nhatnamhuynh/obstacle-detection-and-distance-measurement/README.md

## 1. Project Overview
This project implements STM32 into an obstacle warning system for vehicles. It triggers the ultrasonic waves, detects obstacles and calculates how far the objects are using the reflected ECHO signal. Based on real-time distance, it warns the user through multiple channels, including LEDs, Buzzer, and LCD display. The system also transmits data logs periodically to the server using the U-ART interface, reporting realistic operation data for testing and future developments.

## 2. Learning Objectives
* Practice embedded C programming on STM32 with HAL library.
* Understanding and applying Timers, Input Capture, Interrupts, I2C, U-ART, PWM, GPIO into a practical project.
* Design a finite state machine for distance-based warning states.
* Implement a non-blocking main loop using time-driven events.
* Apply logical framework into utilizing the overall system and deliver cutting-edge test cases. 
* Enhance documentation and project presentation.

## 3. Hardware

### 3.1. Overview
Below is the detailed Bill of Materials (BOM) used to build the system:

| Component Category | Part / Module Name | Description / Specifications |
| :--- | :--- | :--- |
| **Microcontroller Board** | STM32F103C8T6 (Blue Pill) | ARM Cortex-M3 core @ 72 MHz |
| **Programmer / Debugger** | ST-Link V2 | SWD programming & debugging interface |
| **Primary Sensor** | HC-SR04 Ultrasonic Module | 2 cm – 400 cm range, 40 kHz acoustic frequency |
| **Display Interface** | 16x2 Character LCD + PCF8574 | I2C communication interface module |
| **Acoustic Actuator** | Passive Piezoelectric Buzzer | Driven via Timer PWM |
| **Visual Indicators** | 3x LEDs (Green, Yellow, Red) | Driven via GPIO with 220Ω current-limiting resistors |
| **User Input** | 1x Tactile Push-Button | Unit conversion (cm / inch), 10kΩ pull-up resistor |
| **Serial Telemetry** | CP2102 USB-to-UART Module | Transmitting logs to Serial Terminal on PC |
| **Software Toolchain** | VS Code, STM32CubeMX, Arm GNU Toolchain, CMake, Ninja, STM32 Programmer CLI| Software tools for programming and compilation |

*Note:* The system uses an independent step-down power supply module to provide 5V (for the sensor and LCD) and a stable 3.3V for the STM32 microcontroller during operation, preventing voltage drops when peripherals are activated.

### 3.2. Pinout Schematic
The peripherals are connected to the STM32 microcontroller through the pin configuration on STM32CubeMX as follows:

| Peripheral | Microcontroller Pin | Function |
| :--- | :--- | :--- |
| **HC-SR04 (Trig)** | `PA1` | GPIO Output |
| **HC-SR04 (Echo)** | `PA0` | Timer Input Capture |
| **Push-Button** | `PA2` | EXTI External Interrupt (Unit conversion) |
| **Green LED (Safe)** | `PB3` | GPIO Output |
| **Yellow LED (Warning)** | `PB4` | GPIO Output |
| **Red LED (Danger)** | `PB5` | GPIO Output |
| **Buzzer** | `PB8` | Timer PWM (Beep frequency control) |
| **LCD 16x2 (SCL)** | `PB6` | I2C SCL |
| **LCD 16x2 (SDA)** | `PB7` | I2C SDA |
| **UART (TX)** | `PA9` | UART TX - Transmit log data to Terminal |
| **UART (RX)** | `PA10` | UART RX - Receive data |

### 3.3. PCB Layout
* **Design Tool:** The project's PCB is professionally designed using **Altium Designer** software.
* **Component Layout:** The board is logically divided into sections including: Headers for the Blue Pill microcontroller, UART module pins, HC-SR04 sensor, LCD screen, push-button area, buzzer, and a cluster of 3 terminal blocks for outputting signals to the warning LEDs.

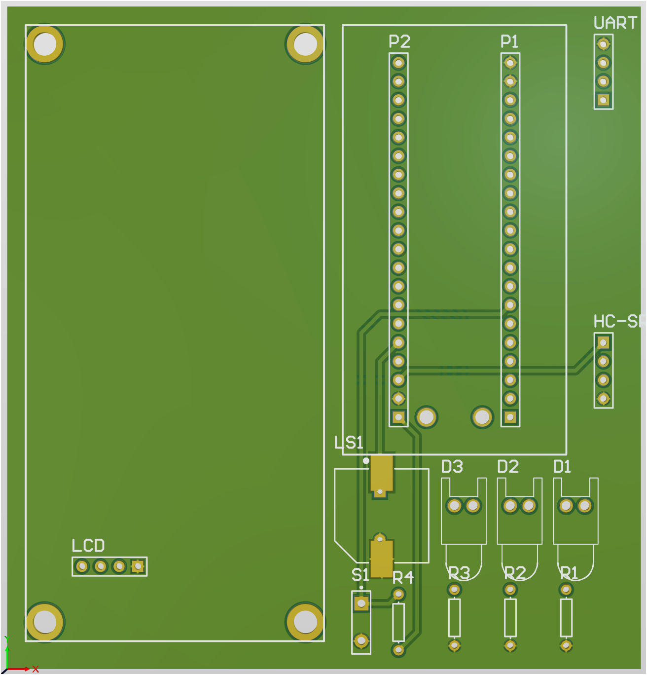
[picture p1: Picture/[MLIoT Project] Front PCB.png]
Front PCB Layout

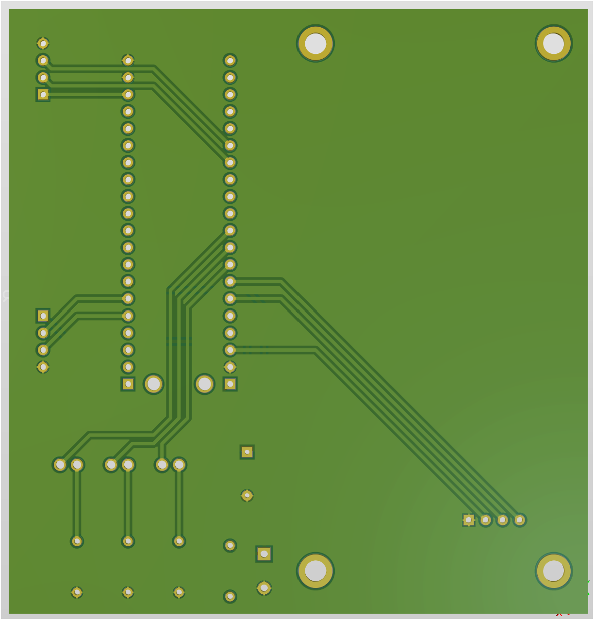
[picture p2: Picture/[MLIoT Project] Back PCB.png]
Back PCB Layout


---

## 4. Software Implementation

### 4.1. Overview: Development Tools and Libraries
The software architecture employs a non-blocking, interrupt-driven design, substituting hardware interrupts for blocking software delays to minimize CPU idle time. The development environment and toolchain consist of:
*   **IDE & Code Editor:** Visual Studio Code.
*   **Configuration & Initialization:** STM32CubeMX.
*   **Compiler & Build System:** Arm GNU Toolchain, CMake, and Ninja.
*   **Flashing & Debugging Tool:** STM32CubeProgrammer CLI (Automated via custom `build_and_flash` shell/batch scripts).
*   **Core Libraries:** Hardware Abstraction Layer (HAL) and Standard C Libraries.

### 4.2. System Block Diagram

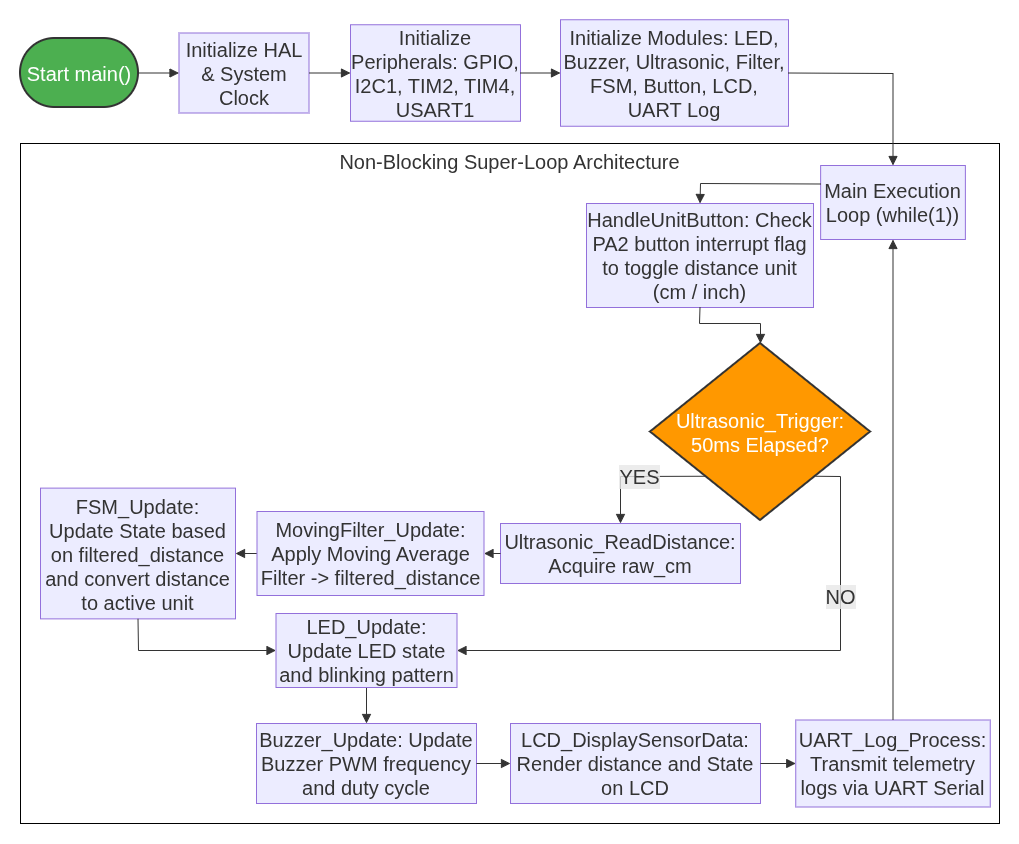
[picture p3: Picture/[MLIoT Project] Main Code Flow - Eng.png]
System Block Diagram
 

### 4.3. Warning State Machine (FSM)
The system utilizes a Finite State Machine (FSM) to classify spatial data into discrete zones and trigger multi-channel alerts (LED and Buzzer).

*   **State 1 - Safe State ($S \ge 50$ cm):** 
    *   The Green LED is turned ON to indicate a safe zone. 
    *   The buzzer remains completely silent.
*   **State 2 - Warning State ($20$ cm $\le S < 50$ cm):** 
    *   The Yellow LED is turned ON and blinks slowly to indicate a mid-range obstacle. 
    *   The buzzer emits a slow beep.
*   **State 3 - Danger State ($S < 20$ cm):** 
    *   The Red LED is turned ON and blinks rapidly to warn of extreme proximity. 
    *   The buzzer emits a rapid, continuous beep to signal an emergency.
*   **State 4 - Out of Range ($S \ge 400$ cm or Echo Timeout):** 
    *   All 3 LEDs are turned OFF. 
    *   The buzzer remains completely silent.

#### State Diagram:
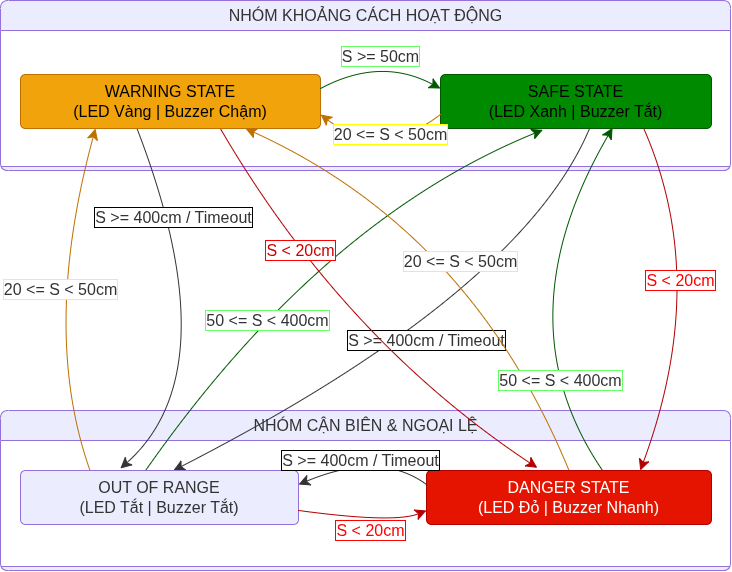
[picture p4: Picture/[MLIoT Project] State Diagram.png]
State Diagram


### 4.4. Signal Acquisition & Processing Flow
The obstacle detection logic relies on hardware time-stamping and digital filtering to ensure high precision with an average error of less than 5%.

*   **Triggering:** The STM32 sends a signal to the HC-SR04 to emit an ultrasonic wave by pulling the TRIG pin HIGH for $10\mu s$, then pulling it LOW.
*   **Echo Capture:** The HC-SR04 emits the ultrasonic pulse and pulls the ECHO pin HIGH until the reflected wave is received, at which point it is pulled LOW.
*   **Time Measurement:** The Timer Input Capture interrupt records time $T_1$ at the rising edge of the ECHO pin and time $T_2$ at the falling edge. The pulse width is calculated as $\Delta t = T_2 - T_1$.
*   **Distance Calculation:** The distance is calculated using the formula $S = \frac{v \times \Delta t}{2}$ (where $v = 0.0343$ cm/$\mu s$, accounting for the round-trip travel of the sound wave).
*   **Digital Filtering:** A Moving Average Filter is applied using the 5 most recent samples ($N=5$) to smooth the data and eliminate sudden noise spikes.

### 4.5. Timing & Interrupt Design
To maintain real-time performance without an RTOS, the system relies heavily on peripheral timers and a strict interrupt priority hierarchy.

*   **Timer Input Capture:** Utilized specifically to measure the Echo pulse width duration for distance calculation.
*   **PWM Control:** A Timer PWM is used to control the passive buzzer, modulating its beep frequency inversely proportional to the measured distance.
*   **SysTick Time Base:** SysTick is implemented to create a time base for the non-blocking FSM and button debouncing.
*   **Display & Communication Cycles:** Telemetry data (distance and state) is packaged into a standard string format and transmitted via UART to a PC terminal with a cycle of 200 ms. The LCD updates simultaneously at this 200 ms interval.
*   **Software Debounce & EXTI:** 
    *   The unit conversion button uses an EXTI interrupt combined with a software debounce technique.
    *   When the EXTI is triggered, the system compares the current time with the last valid press timestamp.
    *   If the difference is $\ge 200$ ms, it is confirmed as a valid press and the timestamp is updated.
    *   If the difference is $< 200$ ms, it is treated as mechanical noise and the event is ignored.
<!-- *   **NVIC Priority Configuration:** The Nested Vectored Interrupt Controller (NVIC) is structured with Timer IC having the highest priority, followed by SysTick, then UART, and finally the EXTI Button with the lowest priority. -->
*   **Timeout & Exception Handling:** Any distance metric exceeding $400\text{ cm}$ automatically transitions the system into the `OUT_OF_RANGE` state. Furthermore, if a new $50\text{ ms}$ trigger cycle begins while the previous Echo measurement is still incomplete (`is_first_captured == 1`), the system detects a missing falling edge and automatically overrides `echo_time_us` to $24,000\ \mu\text{s}$ ($\approx 411.6\text{ cm}$). This forces an immediate `OUT_OF_RANGE` state, resetting the Input Capture state machine and preventing timer corruption.

## 5. Final Product
The demo video demonstating how the system operates and delivers warning signal through LEDs, Buzzer, LCD Display, and U-ART log:
▶️ [Obstacle Detection and Distance Measurement](https://youtu.be/Erm0Eq_RM2c?si=jHDenFR6_XJYcfAd)

## 6. Performance Analysis
The testing is carried out under 3 stages:
* Level 1 - Components testing: ensuring each component performs its function properly.
* Level 2 - Unit (block) testing: checking whether each block delivers the correct output based on provided input combinations.
* Level 3 - System testing: observing interactions between functional blocks and the general outputs of the system; gathering data for performance analysis.

### 6.1. Level 1: Component testing

| Test | Context | Result |
| :--- | :--- | :---: |
| **LEDs test** | Toggle the three LEDs each 500ms | **Passed** |
| **Buzzer test** | Enable the buzzer to signal | **Passed** |
| **LCD test** | Display the string “Hello” onto LCD | **Passed** |
| **U-ART test** | Transmit the string “UART functions normally!” | **Passed** |

---

### 6.2. Level 2: Unit (Block) Testing

| Test | Context | Result |
| :--- | :--- | :---: |
| **Input Block** | Trigger the HC-SR04 20 times, collect raw distance, and check the state updates | **Passed** |
| **Display and Communications Block** | Sequentially provide four distinct state data (S/W/D/OOR), observe the LCD display string and the UART log | **Passed** |
| **Actuators Block** | Sequentially provide four distinct state data (S/W/D/OOR), check for the reaction of LEDs and Buzzer | **Passed** |

---

### 6.3. Level 3: System Testing

#### Surface Properties
| Test Scenario | Context / Observation | Result |
| :--- | :--- | :--- |
| **Purely flat, perpendicular surface** | Baseline accuracy | Average errors = 1.81% |
| **Curved surface** | Error is relatively large with near objects (2cm, 19%) and decreases for further cases | Average error = 1.86% (further cases) |
| **Deformed surface** | Error is relatively large with near objects (2cm, 49%) and decreases for further cases | Average error = 2.36% (further cases) |
| **Empty box** | Wave is reflected at the bottom of the box instead of the nearest side as expected; error decreases as object gets further | Average error = 54.07% |

#### Surface Angle
| Test Scenario | Context / Observation | Result |
| :--- | :--- | :--- |
| **Inclined surface** | Angle with the vertical should be at most 15° for acceptably correct distance (<5%); error increases as angle increases | Max 15° (<5% error) |

#### Surface Texture
| Test Scenario | Context / Observation | Result |
| :--- | :--- | :--- |
| **Foam and mesh** | Sensor cannot detect reflected waves as the material has either absorbed or let it travel through | **OUT OF RANGE** |

#### Field of View
Place the obstacle at different positions not on the direct axis from the sensor and observe how far until reaching an incorrect distance (>5%).

* **Horizontal:** Left: 14.0° | Right: 15.4°
* **Vertical:** Up: 12.7° | Down: 14.9°

---

### 6.4. Conclusion

* **Successfully fulfilled correct distance estimation target:** Final product can properly detect most solid obstacles and calculate the distance in a range of 2–400cm, with an average error less than 5%.
* **Smoothly implemented state-based warning logic:** The FSM transition is correct at turning points (20cm, 50cm, and 400cm); the warning state is consistent between channels (LEDs, Buzzer, LCD Display, and UART Log).
* **Reliably maintained communication operation:** The system can operate continuously for 30 minutes without lockup conditions; data is periodically transmitted through UART and I2C.
* **Explicitly identified physical limits of the sensors:** Test cases covered four major variables including surface properties, angle, texture, and field of view, indicating the limits of ultrasonic waves for each type of surface encountered.

## 7. Limitations and Future Developments
### 7.1. Limitations

* The HC-SR04 may encounter echo noises, making it difficult to detect sound-obsorbing materials or inclined surfaces.
* The interrupts may lead to conflicts when scaling this system to a larger one, with multiple sensors. It can also cause extreme power drop when all peripherals are active at the same time.

---

### 7.2. Future developments

* **Hardware:** supply external power with bucking circuits to ensure stable 3.3V/5V voltage (depending on each component) during operation; consider other sensors for more precise distance calculations.
* **Software:** tightly configure the Nested Vectored Interrupt Controller (NVIC) to avoid conflicts: `Timer Input Capture` $\rightarrow$ `SysTick / UART` $\rightarrow$ `EXTI (Button)`

## 8. Authors:
* Huynh Nhat Nam
* Pham Minh Huy
* Than Duc Phat
