nhatnamhuynh/obstacle-detection-and-distance-measurement/Core/Src/main.c

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
/* Includes ------------------------------------------------------------------*/
#include "main.h"

/* USER CODE BEGIN Includes */
#include "ultrasonic.h"
#include "moving_filter.h"
#include "median_filter.h"
#include "buzzer.h"
#include "led.h"
#include "fsm_alarm.h"
#include "lcd_i2c.h"
#include "button_exti.h"
#include "uart_log.h"
#include "test_led.h"
#include "test_buzzer.h"
#include "test_lcd.h"
#include "test_runner.h"
/* USER CODE END Includes */

I2C_HandleTypeDef hi2c1;

TIM_HandleTypeDef htim2;
TIM_HandleTypeDef htim4;

UART_HandleTypeDef huart1;

/* USER CODE BEGIN PV */
// Global variables
SensorData_t g_data;
Led_t g_led;
Button_t g_btn;
Buzzer_t g_buzzer;
MovingFilter_t g_filter;
/* USER CODE END PV */

void SystemClock_Config(void);
static void MX_GPIO_Init(void);
static void MX_I2C1_Init(void);
static void MX_TIM2_Init(void);
static void MX_TIM4_Init(void);
static void MX_USART1_UART_Init(void);
/**
  * @brief  The application entry point.
  * @retval int
  */
int main(void)
{

  /* MCU Configuration--------------------------------------------------------*/

  /* Reset of all peripherals, Initializes the Flash interface and the Systick. */
  HAL_Init();

  /* Configure the system clock */
  SystemClock_Config();

  /* Initialize all configured peripherals */
  MX_GPIO_Init();
  MX_I2C1_Init();
  MX_TIM2_Init();
  MX_TIM4_Init();
  MX_USART1_UART_Init();
/* USER CODE BEGIN 2 */
  LED_Init (&g_led, 
            GPIOB, GPIO_PIN_5, //green = PB5
            GPIOB, GPIO_PIN_4, // yellow = PB4
            GPIOB, GPIO_PIN_3); // red = PB3
  
  Buzzer_Init (&g_buzzer, &htim4, TIM_CHANNEL_3); // buzzer = TIM4_CH3

  Ultrasonic_Init();

  MovingFilter_Init(&g_filter);

  FSM_Init (&g_led, &g_buzzer);

  Button_Init (&g_btn, GPIOA, GPIO_PIN_2); // Button = PA2

  //Protocol (not merge yet)
  LCD_Init();
  UART_Log_Init();

  #if ENABLE_HARDWARE_TESTBENCH
    TestRunner_RunAll();
  #endif
  /* USER CODE END 2 */

  /* Infinite loop */
  /* USER CODE BEGIN WHILE */
  while (1)
  {
    // Interrupt for checking the button
    HandleUnitButton(&g_btn, &g_data);

    //Interrupt for checking the sensor every 50ms
    if (Ultrasonic_Trigger()) {
      float raw_cm = Ultrasonic_ReadDistance();
      float filtered_cm = raw_cm;
      // if want to test one filter, comment the other one's line
      filtered_cm = MedianFilter_Update(filtered_cm); // median filter first
      filtered_cm = MovingFilter_Update(&g_filter, filtered_cm);

      FSM_Update(filtered_cm, &g_data); // Update the FSM state and filtered distance
    }


    // Led and Buzzer will always wait for being triggered
    LED_Update(&g_led, g_data.state);
    Buzzer_Update (&g_buzzer, g_data.state);

    LCD_DisplaySensorData(&g_data);
    UART_Log_Process(&g_data);

    /* USER CODE END WHILE */

    /* USER CODE BEGIN 3 */
  }
  /* USER CODE END 3 */
}

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
/* USER CODE BEGIN 4 */
void HAL_GPIO_EXTI_Callback(uint16_t GPIO_Pin)
{
  Button_EXTI_Callback(&g_btn, GPIO_Pin);
}

/* TIM input-capture callback is implemented in `ultrasonic.c`.
 * Removing the forwarding call to `Ultrasonic_CaptureCallback` which
 * was not declared/defined and caused an implicit-declaration warning.
 */
/* USER CODE END 4 */
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
