nhatnamhuynh/obstacle-detection-and-distance-measurement/Core/Inc/main.h

#define TRIG_PIN GPIO_PIN_1   // PA1
#define TRIG_PORT GPIOA
#define ECHO_PIN GPIO_PIN_0   // PA0 (TIM2_CH1)
#define ECHO_PORT GPIOA
#define LED_GREEN_PIN GPIO_PIN_5   // PB5 (Safe)
#define LED_GREEN_PORT GPIOB
#define LED_YELLOW_PIN GPIO_PIN_4  // PB4 (Warning)
#define LED_YELLOW_PORT GPIOB
#define LED_RED_PIN GPIO_PIN_3     // PB3 (Danger)
#define LED_RED_PORT GPIOB
#define BTN_UNIT_PIN GPIO_PIN_2   // PA2 (EXTI2)
#define BTN_UNIT_PORT GPIOA
#define BUZZER_PIN GPIO_PIN_8   // PB8 (TIM4_CH3)
#define BUZZER_PORT GPIOB
#define I2C_SCL_PIN GPIO_PIN_6   // PB6 (I2C1_SCL)
#define I2C_SDA_PIN GPIO_PIN_7   // PB7 (I2C1_SDA)
#define UART_TX_PIN GPIO_PIN_9   // PA9 (USART1_TX)
#define UART_RX_PIN GPIO_PIN_10  // PA10 (USART1_RX)
