nhatnamhuynh/obstacle-detection-and-distance-measurement/Core/Inc/ultrasonic.h

#ifndef __ULTRASONIC_H
#define __ULTRASONIC_H

#include "main.h"

void Ultrasonic_Init(void);
bool Ultrasonic_Trigger(void);
float Ultrasonic_ReadDistance(void);
// the interrupt function is included in the HAL library so we dont need to declare it anymore

#endif /* __ULTRASONIC_H */
