nhatnamhuynh/obstacle-detection-and-distance-measurement/Core/Src/moving_filter.c

#include "moving_filter.h"

void MovingFilter_Init(MovingFilter_t *filter) {
    if (filter == NULL) return;

    filter->count = 0;
    filter->index = 0;
    filter->sum = 0.0f;
    for (uint8_t i = 0; i < FILTER_WINDOW_SIZE; i++) {
        filter->buffer[i] = 0.0f;
    }
}

float MovingFilter_Update(MovingFilter_t *filter, float input_value) {
    if (filter == NULL) return 0.0f;

    if (input_value < 0.0f) {
        if (filter->count > 0) {
            return filter->sum / (float) filter->count; // return the current avg;
        }
        else return 0.0f;
    }

    if (filter->count == FILTER_WINDOW_SIZE) {
        filter->sum -= filter->buffer [filter->index];
    }else {
        filter->count++;
    }

    filter->buffer [filter->index] = input_value;
    filter->sum += filter->buffer [filter->index];

    filter->index = (filter->index + 1) % FILTER_WINDOW_SIZE;  // ring shifting the index
    return filter->sum / (float) filter->count;
}
