nhatnamhuynh/obstacle-detection-and-distance-measurement/(commit log)

2026-08-12 feat: add ultrasonic timer input capture
2026-08-12 feat: done module ultrasonic
2026-08-14 feat: update module ultrasonic
2026-08-14 feat: finish the overall main.c (included the button module)
2026-08-14 feat: add lcd i2c code
2026-08-14 feat: add uart_log code
2026-08-15 feat: modify uart_log code
2026-08-15 fix: update and rewrite some logic of led, buzzer, fsm_alarm and main.c
    [buzzer.c, buzzer.h, fsm_alarm.c, fsm_alarm.h, led.c, led.h, main.c, main.h]
2026-08-16 fix: update main.c flow
    [button_exti.c, button_exti.h, fsm_alarm.c, fsm_alarm.h, main.c, ultrasonic.c, ultrasonic.h]
2026-08-18 feat: add display_test module and fix CMakeLists.txt
    [display_test.c, main.c]
2026-08-19 fix: fix a little of testbench
    [display_test.c]
2026-08-26 feat:add led, buzzer, lcd, uart test
    [main.c, test_buzzer.c, test_lcd.c, test_led.c, test_runner.c]
2026-08-26 tests: modify block tests flow
2026-08-26 Update gitignore for STM32
2026-08-31 feat: add median filter
2026-09-04 fix: finalize logic & testcases
    [display_test.c, lcd_i2c.c, led.c, main.c, main.h, test_buzzer.c, test_lcd.c, test_led.c]
2026-09-05 update: update time interval of LCD and UART log
